Tb113/fyst-primecam-optics-tube-1-4-scale-model/Optics Tube Inner Ring Scale Model.step.SLDPRT

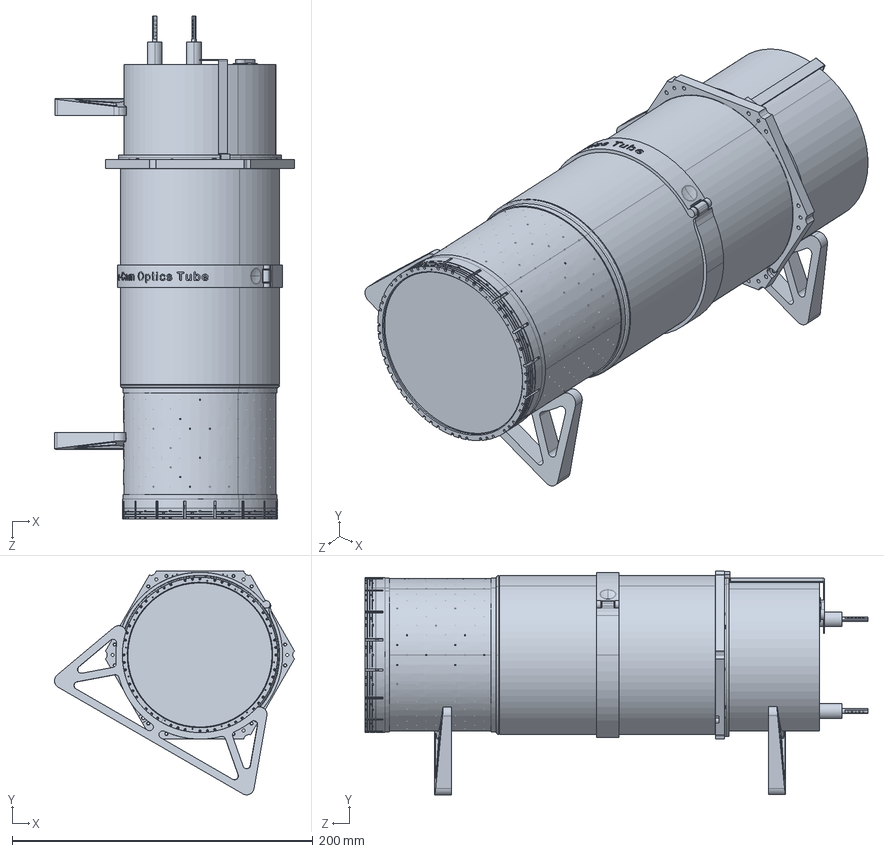
[picture p1: CAD file, 2026-06-29]
Optics Tube Inner Ring Scale Model.step.SLDPRT
159.5 x 148.7 x 334.2 mm
