Tb113/fyst-primecam-optics-tube-1-4-scale-model/OT_4K_Primary.stl

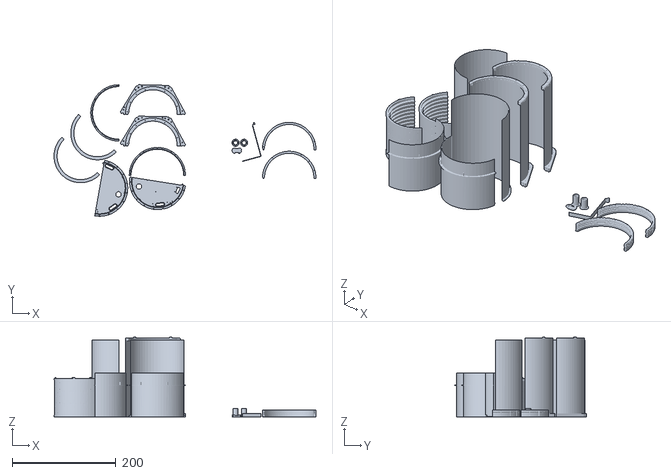
[picture p2: CAD file, 2026-05-19]
OT_4K_Primary.stl
504.4 x 253.3 x 153.3
