Tb113/fyst-primecam-optics-tube-1-4-scale-model/OT_4K_Secondary.stl

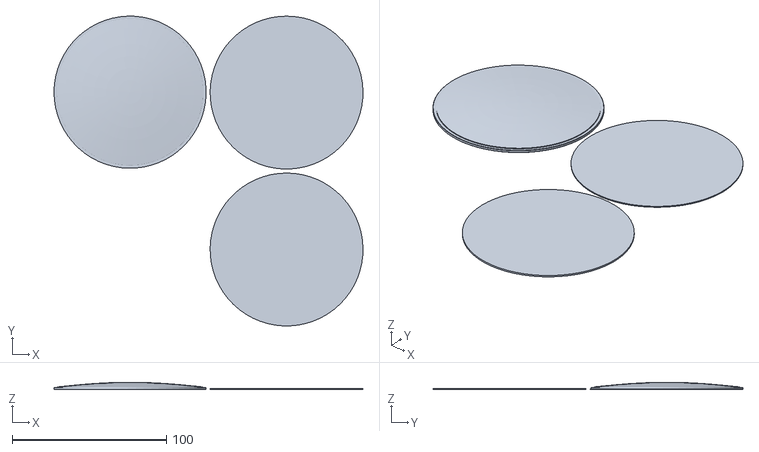
[picture p3: CAD file, 2026-05-19]
OT_4K_Secondary.stl
200.1 x 200.5 x 4.83
