Tb113/fyst-primecam-optics-tube-1-4-scale-model/OT_1K_Primary.stl

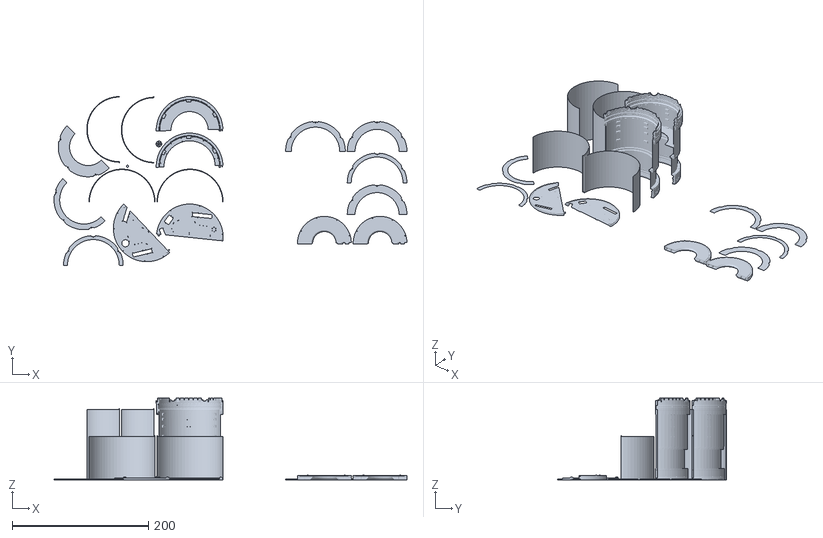
[picture p4: CAD file, 2026-05-19]
OT_1K_Primary.stl
517.8 x 247.8 x 119.8
