Tb113/fyst-primecam-optics-tube-1-4-scale-model/OT_1K_Secondary.stl

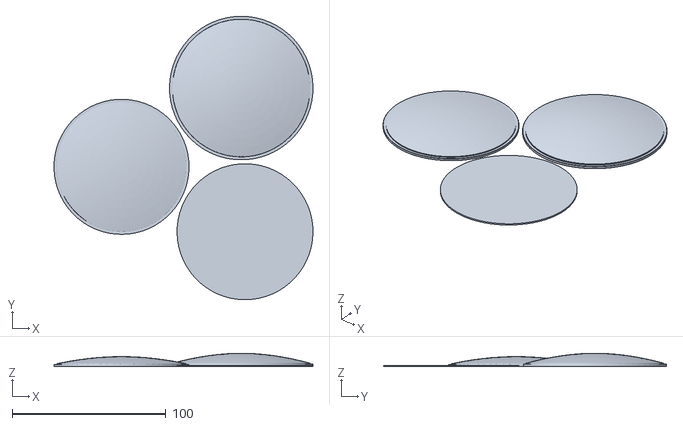
[picture p5: CAD file, 2026-05-19]
OT_1K_Secondary.stl
168.7 x 184.6 x 8.79
