Tb113/fyst-primecam-optics-tube-1-4-scale-model/OT_100mK_Primary.stl

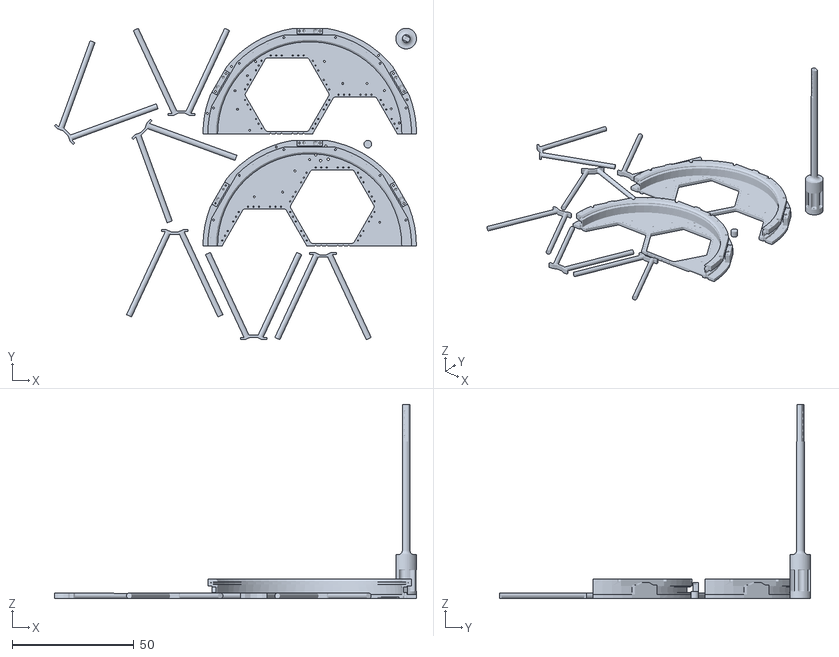
[picture p6: CAD file, 2026-05-19]
OT_100mK_Primary.stl
148.4 x 127.7 x 79.6
