Tb113/fyst-primecam-optics-tube-1-4-scale-model/OT_100mK_Secondary_And_Supplemental.stl

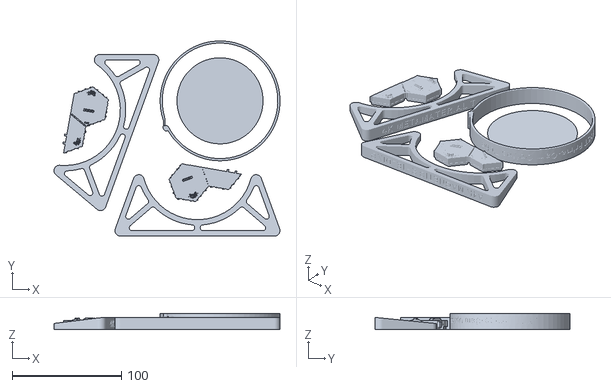
[picture p7: CAD file, 2026-05-19]
OT_100mK_Secondary_And_Supplemental.stl
207.1 x 178.8 x 15.0
