Tb113/fyst-primecam-optics-tube-1-4-scale-model/Optics Tube Scale Model Assembly Guide - 5_19_26.pdf

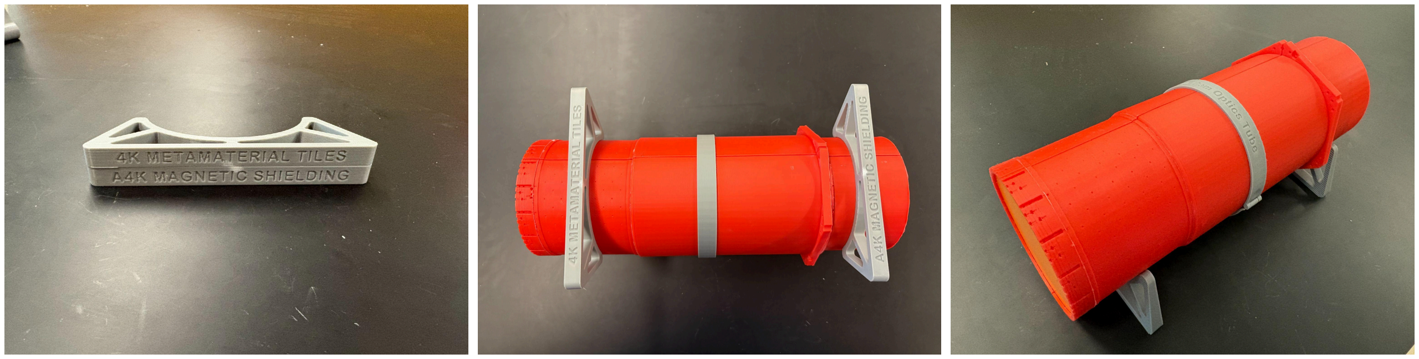
[picture p23: figure]
